cev64/sportsticker/enclosure/renders/back_open.png

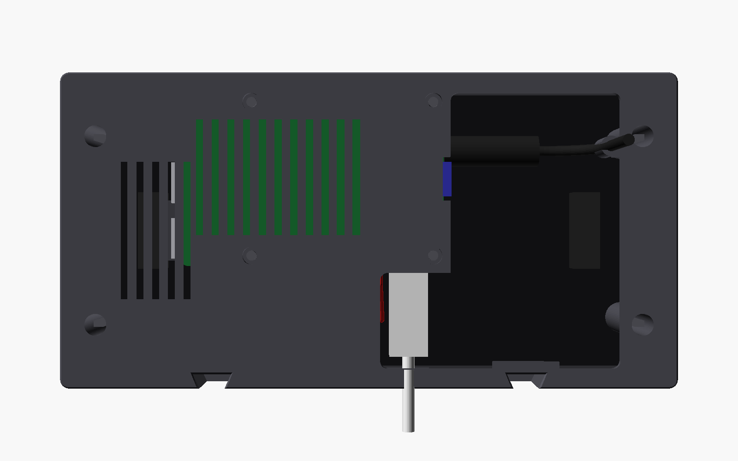
enclosure/renders/back_open.png
