cev64/sportsticker/enclosure/renders/front.png

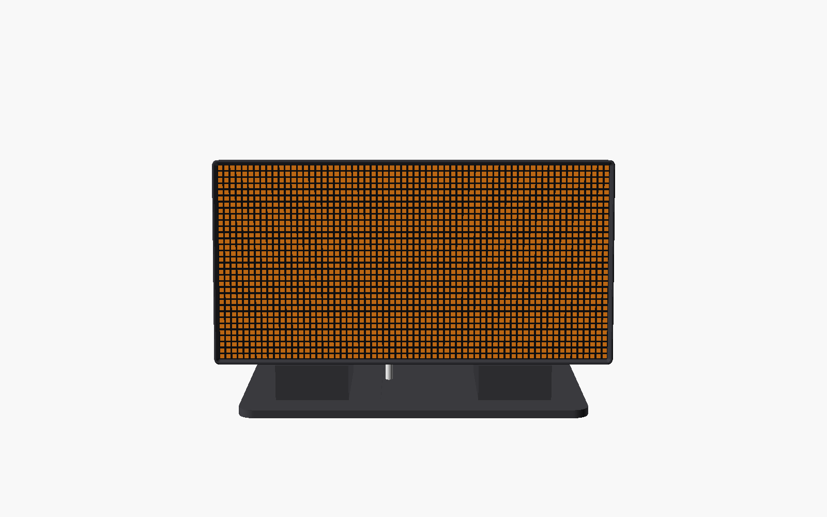
enclosure/renders/front.png
