cev64/sportsticker/enclosure/renders/section2.png

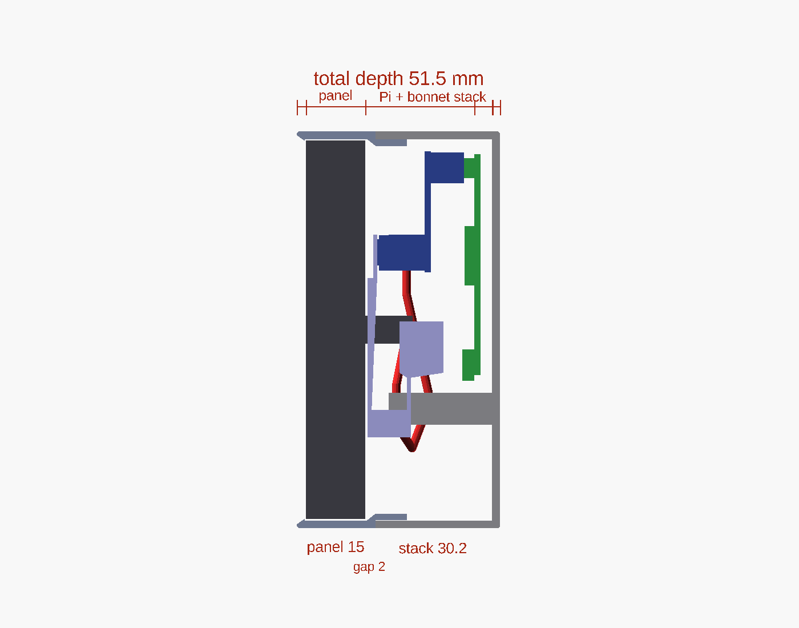
enclosure/renders/section2.png
