cev64/sportsticker/enclosure/stl/snap_pins.stl

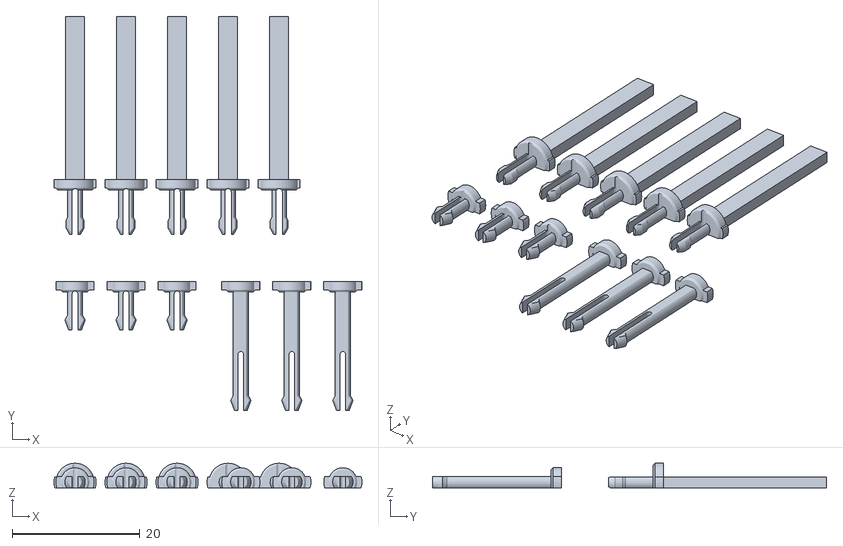
[picture p22: CAD file, 2026-10-12]
enclosure/stl/snap_pins.stl
48.3 x 61.8 x 3.86
