cev64/sportsticker/enclosure/stl/two_panel/shell_left.stl

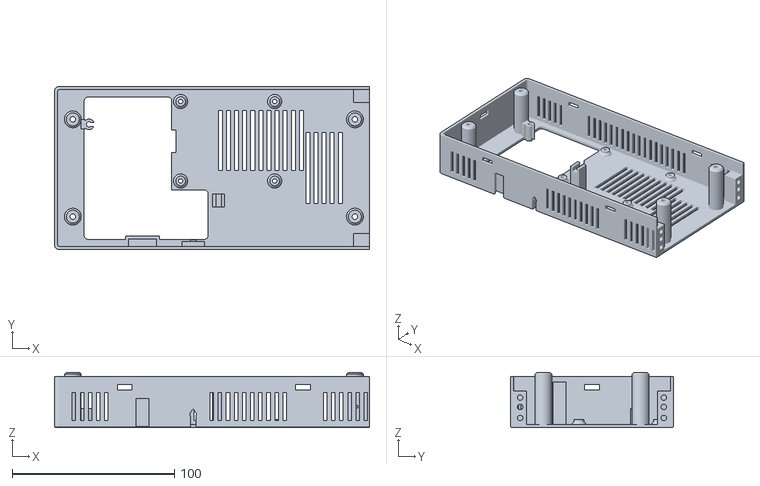
[picture p23: CAD file, 2026-10-12]
enclosure/stl/two_panel/shell_left.stl
194.3 x 100.6 x 34.2
