cev64/sportsticker/enclosure/stl/coupon.stl

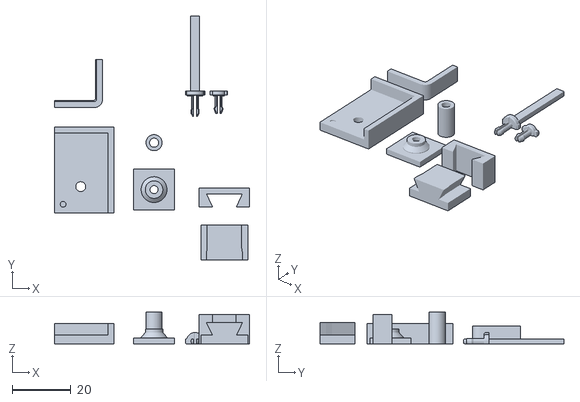
[picture p24: CAD file, 2026-10-12]
enclosure/stl/coupon.stl
66.6 x 83.2 x 10.8
