cev64/sportsticker/enclosure/stl/two_panel/stand_right.stl

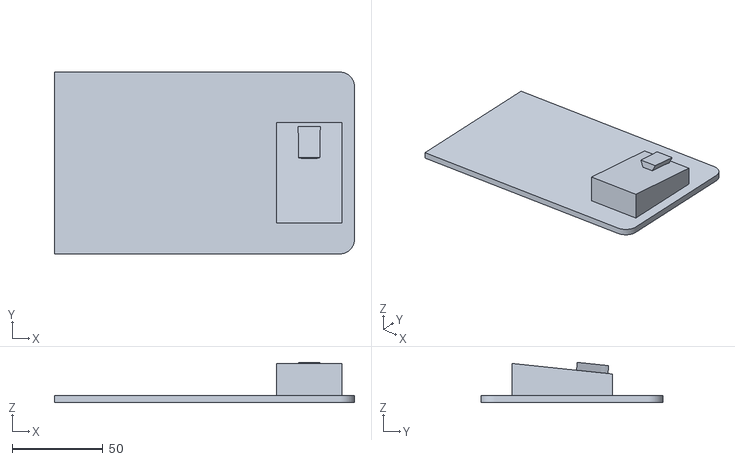
[picture p25: CAD file, 2026-10-12]
enclosure/stl/two_panel/stand_right.stl
165.0 x 100.0 x 22.2
