cev64/sportsticker/enclosure/stl/spacers.stl

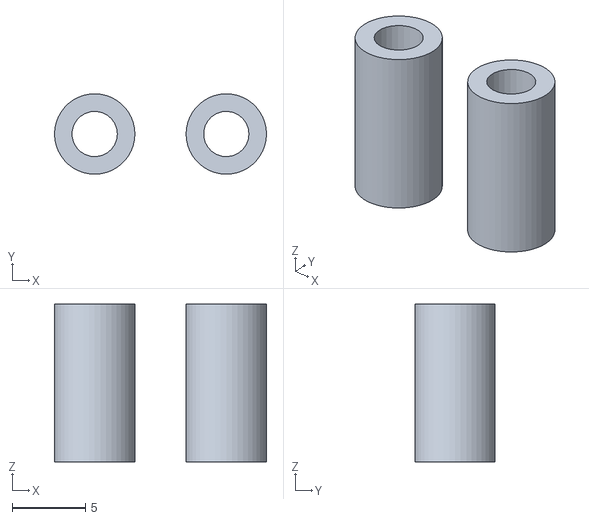
[picture p26: CAD file, 2026-10-12]
enclosure/stl/spacers.stl
14.5 x 5.50 x 10.8
