cev64/sportsticker/enclosure/stl/stand.stl

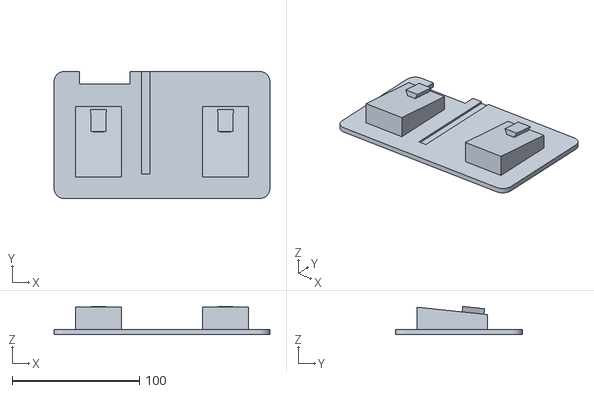
[picture p27: CAD file, 2026-10-12]
enclosure/stl/stand.stl
170.0 x 100.0 x 22.2
