cev64/sportsticker/enclosure/stl/shell.stl

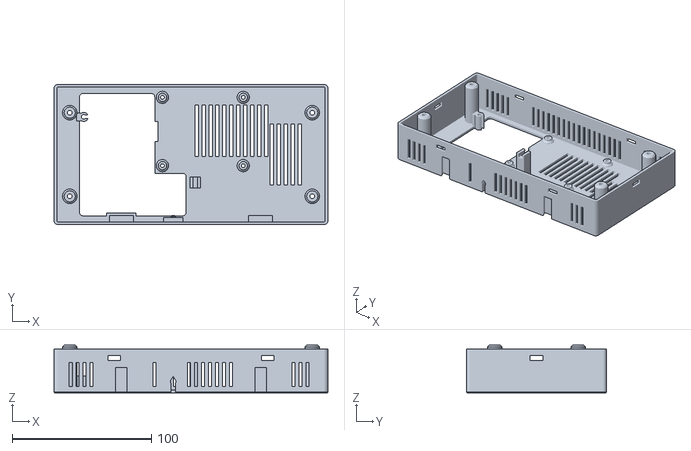
[picture p28: CAD file, 2026-10-12]
enclosure/stl/shell.stl
196.6 x 100.6 x 34.2
