cev64/sportsticker/enclosure/stl/two_panel/snap_pins.stl

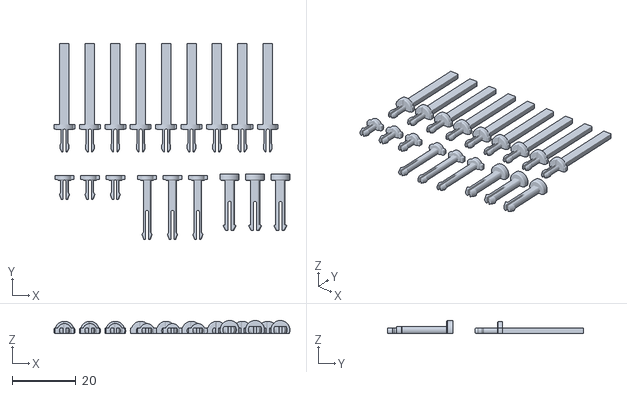
[picture p29: CAD file, 2026-10-12]
enclosure/stl/two_panel/snap_pins.stl
74.3 x 61.8 x 4.12
