cev64/sportsticker/enclosure/stl/bezel.stl

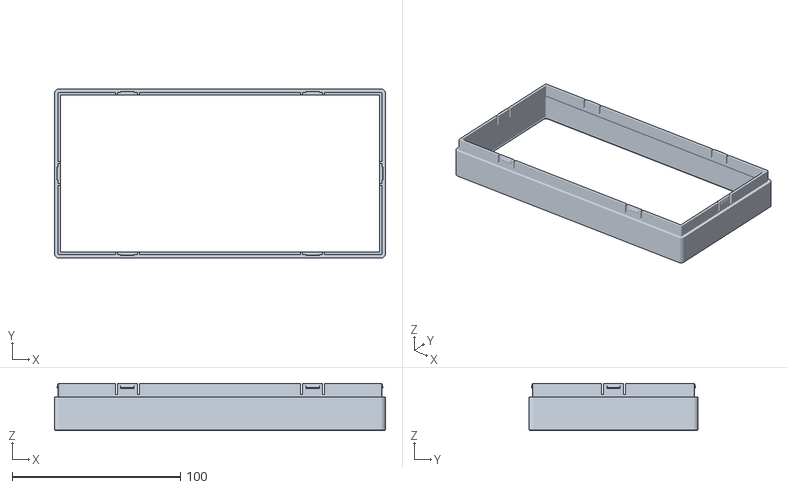
[picture p30: CAD file, 2026-10-11]
enclosure/stl/bezel.stl
196.6 x 100.6 x 28.1
