cev64/sportsticker/enclosure/stl/two_panel/shell_right.stl

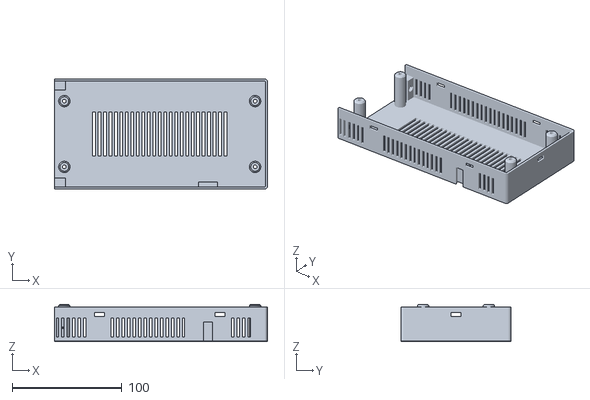
[picture p31: CAD file, 2026-10-12]
enclosure/stl/two_panel/shell_right.stl
194.3 x 100.6 x 34.2
