cev64/sportsticker/enclosure/stl/two_panel/bezel_left.stl

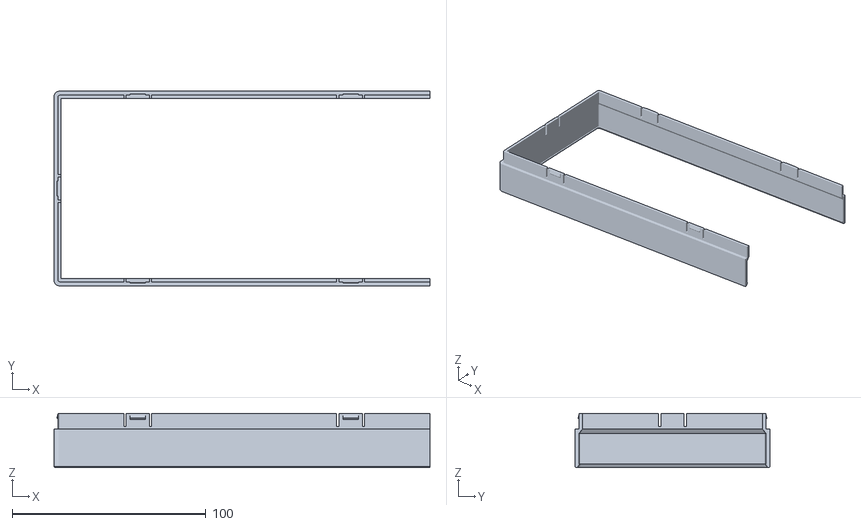
[picture p32: CAD file, 2026-10-11]
enclosure/stl/two_panel/bezel_left.stl
194.3 x 100.6 x 28.1
