cev64/sportsticker/enclosure/stl/two_panel/pins.stl

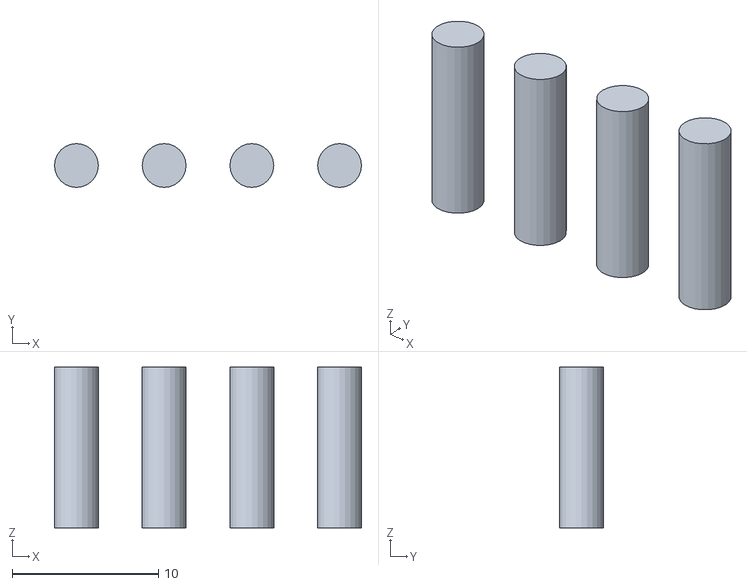
[picture p33: CAD file, 2026-10-11]
enclosure/stl/two_panel/pins.stl
21.0 x 3.00 x 11.0
