cev64/sportsticker/(list of files, cad)

Other CAD files:
enclosure/stl/two_panel/spacers.stl
enclosure/stl/two_panel/stand_left.stl
enclosure/stl/two_panel/bezel_right.stl
