cev64/sportsticker/(commit log)

2026-10-11 Scaffold: config, data model, BDF fonts, display backends, color helpers
    Frames are composed as 64x32 Pillow images and pushed with one SetImage()
    per frame onto an offscreen canvas, then SwapOnVSync(), so the Pi, the
    emulator and headless snapshots render identically.
    Claude-Session: https://claude.ai/code/session_011hkHuWkkGK21FmYDDPA5Qm
    [config.yaml]
2026-10-11 Add LED-dot and pixel-grid preview renderers
    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
2026-10-11 Add team logo store: fetch from ESPN JSON URLs, cache, LED-tuned scaling
    Logos download on a background thread the first time a team appears, are
    trimmed, premultiplied-LANCZOS resized, composited on black and boosted,
    and cached on disk (never in the repo) with pre-scaled copies per size.
    Auto-picks logo vs logoDark by readability on black. Includes prefetch
    and a logo preview contact-sheet script.
    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
2026-10-11 Add ESPN client, background poller, replay and fake-live sources
    Defensive scoreboard parsing (never raises), today-filter with a 4 AM
    rollover, college filtering to ranked teams plus favorites, adaptive
    polling (30 s live / 5 min idle / hourly overnight, 30 s floor), per-league
    exponential backoff keeping last good data. Fixtures recorded live on
    Sunday 2026-10-11 (pre, live and final games).
    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
2026-10-11 Add CLI (run/snapshot/logos/fixtures) and headless snapshot renderer
    Snapshot writes exact 64x32 PNGs, 10x LED renders and pixel-grid views
    for every slide, layout comparisons, rotation/score-flash/transition GIFs,
    contact sheets and a manifest. Pre-game scores are hidden and football
    down & distance is compacted (3rd & 10 -> 3&10).
    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
2026-10-11 Cut memory 254 MB -> 54 MB and remove first-frame stall; add gallery site
    - Logo worker calls malloc_trim after each batch (glibc kept ~200 MB of
    freed image buffers); systemd unit sets MALLOC_ARENA_MAX=2.
    - Preload all fonts at startup (worst frame 125 ms -> 9 ms); drop 3
    unused fonts.
    - site.py: self-contained index.html gallery with a pixel inspector
    (LED / grid / actual-size views, hover for x,y and #rrggbb, copy the
    64x32 pixel array as JSON).
    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
2026-10-11 Add 3D-printable enclosure: OpenSCAD model, STLs, renders, guide
    Parametric OpenSCAD case for the 64x32 P3 panel (Adafruit #2279),
    Raspberry Pi 4 and RGB Matrix Bonnet: slim bezel that hides no pixels,
    rear shell that holds the panel by its M3 inserts with the Pi stack
    facing the panel (51.5 mm total depth), rear access bay for the barrel
    jack, USB-C and microSD, cable strain-relief clips, top/bottom/back
    vents, and a 12-degree desk stand. No supports, no inserts, no solder.
    - enclosure.scad: every part dimension as a commented parameter, with
    UNVERIFIED values flagged; one module per part; diffuser, 2-panel
    (auto-split for the bed) and wall-mount options.
    - STLs in print orientation, a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
    [bezel.stl, bezel_left.stl, bezel_right.stl, coupon.stl, enclosure.scad, pins.stl, shell.stl, shell_left.stl]
2026-10-11 Enclosure: lower the desk stand tilt from 12 to 6 degrees
    Re-exported the stand STLs (single and two-panel), re-rendered the views
    that show the stand, and updated the guide's tilt and stand print
    estimates. Collision checks still pass.
    Claude-Session: https://claude.ai/code/session_01JKcmQdnYG2PwXztrExDNY5
    [bezel_left.stl, coupon.stl, enclosure.scad, shell.stl, shell_left.stl, shell_right.stl, stand.stl, stand_left.stl]
2026-10-11 Enclosure: add a gallery of nine views on the 6-degree stand
    render.sh now also writes renders/views/ (eye level, both front and
    back three-quarters, low angle, side profile, top down, exploded), and
    the guide shows them in a Gallery section that labels the USB-C and
    barrel cables seen at the back.
    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
2026-10-11 Enclosure: screwless build with printed snap pins and a dovetail stand
    The default build (fasteners = "printed") needs no screws or nuts:
    - panel: printed split pins down the existing wells grip the panel's M3 inserts
    - Pi + bonnet: snap pins through the boards click into pockets behind the standoffs
    - stand: dovetail tongues slide into grooves in the shell's bottom bosses
    - 2-panel shell joint: a printed pin catches in the old nut trap
    fasteners = "screws" keeps the previous M3 / M2.5 build. All collision
    checks pass for the default, panels=2 and use_diffuser=true builds.
    Claude-Session: https://claude.ai/code/session_01QDHBfSyGJppXEE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
    [coupon.stl, enclosure.scad, shell.stl, shell_left.stl, shell_right.stl, snap_pins.stl, spacers.stl, stand.stl]
2026-10-11 Enclosure README: document the screwless build
    Claude-Session: https://claude.ai/code/session_01QDHBfSyGJppXEEBk8SrtAC
2026-10-11 Enclosure: re-render previews for the screwless build
    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
2026-10-11 Enclosure: harden the snap pins after a design review
    - Pi standoffs get a flared foot: the barb pocket left only a 0.2 mm ring
    - panel pins: thin neck + bulge spring (strain ~0.7%, was ~10%), and a
    stem up the well so they can be pushed in and pulled back out
    - Pi pins catch on a fixed step 0.4 mm up the bore; the sloped catch
    clamps any stack within +-0.2 mm (1.4 or 1.6 mm PCB); barb 3.2, slit 0.9,
    round slit roots
    - joint pin gets a square catch and a 4.2 mm barb
    - pin heads get a bar across the split so they cover the hole all round
    - 0.6 mm chamfer at the dovetail groove mouth against elephant foot
    - coupon piece E moved into frame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
    [coupon.stl, enclosure.scad, shell.stl, shell_left.stl, shell_right.stl, snap_pins.stl, spacers.stl, stand.stl]
2026-10-11 Enclosure: re-render previews after the pin fixes; frame the whole coupon
    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
2026-10-12 Enclosure: back and stand-slide renders of the screwless design
    Adds a stand_slide view (the case slid forward off the dovetails) and two
    light-grey gallery renders that show the pin wells, Pi pin pockets and
    dovetails.
    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
    [enclosure.scad]
2026-10-15 Add a vertical scroll transition and use it
    transition_style "scroll": the current slide scrolls up and out while the
    next one rises from the bottom, with the same ease-out as the others.
    config.yaml now uses it. The README config table gains transition_style
    and shows the shipped transitions / transition_ms values.
    Claude-Session: https://claude.ai/code/session_01NUSftycJcPFWM3NgWU886Q
2026-10-19 README: pick the Legacy (Bookworm) Lite image in Imager
    Imager's default Raspberry Pi OS Lite (64-bit) entry is now Trixie.
    The setup steps were written for Bookworm, which Imager lists as
    Raspberry Pi OS (Legacy, 64-bit) Lite under Raspberry Pi OS (other).
    Claude-Session: https://claude.ai/code/session_01Ssa5MakFLZwkaBbBCFw1ob
